youkoutaku/Mobile-Robot/Program/参考資料/PSDセンサ/プログラム/ReadMe.txt

					
● 注）Arduino と H8 のグランドを共通にすること！

Arduino\psd_test ... Arduino用
　　PSDセンサの値を読み，
　　13番ピンから，0か1かの信号を送るプログラム．
　　閾値以上ならば1をそれ以外は0を出力する．
　　超音波センサのH8\piを使用して
　　Arduinoからの信号を，PIでチェック可能．

H8\ad ... H8用 
　　PSDセンサの値を読み，
　　計測アナログ値と変換電圧を表示するプログラム．
