youkoutaku/Mobile-Robot/Program/参考資料/超音波センサ/プログラム/ReadMe.txt

● 注）Arduino と H8 のグランドを共通にすること！

Arduino\sonic_test_z ... Arduino用
　　超音波センサの値を読み，
　　13番ピンから，0か1かの信号を送るプログラム．
　　閾値以上ならば1をそれ以外は0を出力する．

H8\pi ... H8用 
　　Arduinoからの信号（0か1かの値）を
　　P2.DR.BIT.B4（CN2-33）から読み取って表示するプログラム．
